hardware-samelement/Panic_button_v2.0/README.md

# Panic_button_v2.0
 Panic Button version 2, new PCB using esp32.
