hardware-samelement/Panic_button_v2.0/document/dokumentasi-panic-button_v2.0.docx

# Panic Button v2

Merupakan upgrade dari versi sebelumnya yaitu v1.1. yang paling membedakan adalah controller diupgrade ke esp32 yang sebelumnya esp12-E.

## Hardware

Untuk board, tidak ada perubahan dari segi bentuk dan dimensi, masih sama dengan versi sebelumnya.

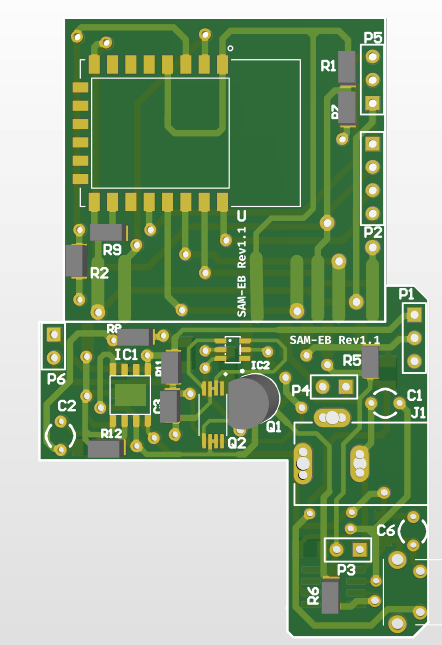
[picture p1: figure]

Gambar 1 Panic Button V1.1

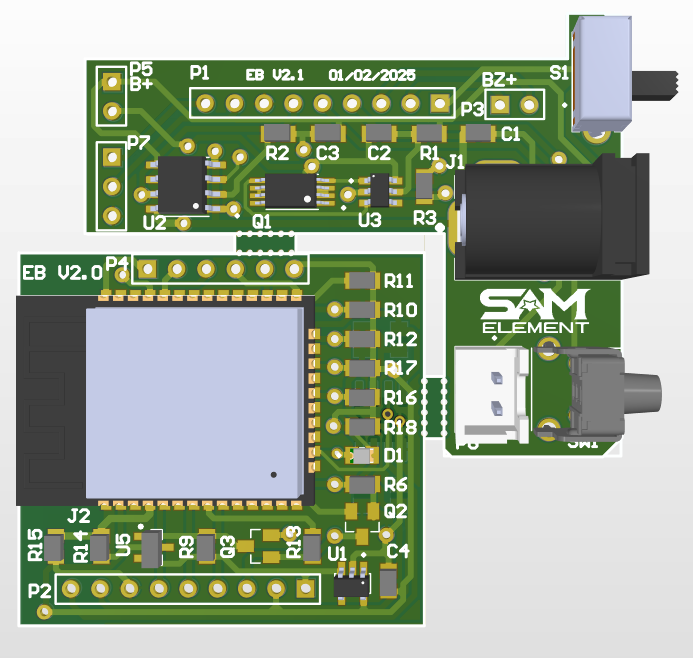
[picture p2: figure]

Gambar 2 Panic Button V2.1

Perubahan yang dapat diperhatikan adalah sebagai berikut:

- Digunakan esp32, letak antenna di luar pcb.
- Rangkaian IC NE555 dihilangkan.
- Ditambahkan regulator 3V3.
- Ditambahkan FET untuk ADC baterai.
- Ditambahkan driver untuk buzzer.
- Header untuk upload code dipindah ke atas.
- Connector antar kedua pcb menggunakan header siku.

### 3.3V regulator

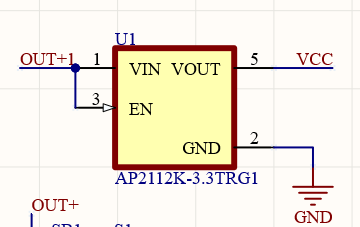
[picture p3: figure]

Gambar 3 LDO 3.3V

Digunakan LDO (low dropout) regulator 3.3V AP2112K, keunggulan regulator tersebut dibanding AMS1117 adalah pada sisi dropoutnya lebih kecil. Sehingga pada saat tegangan baterai sudah ada di 3.7V regulator tersebut masih bisa stabil mengeluarkan tegangan di 3.3V. pada versi 1.1 tidak terdapat regulator sama sekali, esp langsung mendapat tegangan dari baterai.

### Enable untuk cek adc baterai

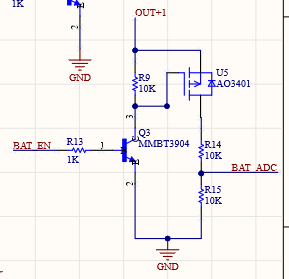
[picture p4: figure]

Gambar 4 rangkain FET untuk adc baterai

Ditambahkan fet untuk enable adc baterai, sehingga pada saat tidak melakukan pengukuran baterai maka potensi power lost pada resistor pembagi tegangan sebelum adc dapat dihilangkan.

### Penambahan komunikasi RS45

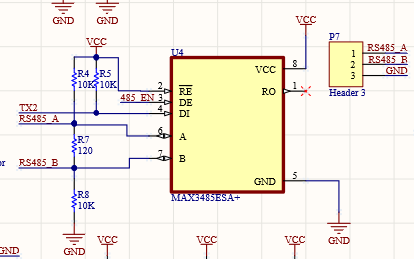
[picture p5: figure]

Gambar 5 rangkaian MAX485

Juga ditambahkan untuk komunikasi max485, antisipasi jika ingin digunakan dengan kabel.

## Firmware

Untuk firmware, terdapat 2 jenis tombol dan 2 jenis komunikasi yang dapat digunakan. Perbedaan tersebut dapat dipilih melalui flag yang ada, flag tersebut yang kemudian akan digunakan untuk memilih task mana yang diaktifkan.

ButtonType buttonType = BUTTON_NC_LOCKED;

// ButtonType buttonType = BUTTON_NO_MOMENTARY;

ConnectivityType connectionType = CONNECTION_WiFi;

// ConnectivityType connectionType = CONNECTION_ESPNOW;

void setup() {

// put your setup code here, to run once:

pinConfig();

Serial.begin(115200);

batteryCalculate();

if (connectionType == CONNECTION_WiFi) {

xTaskCreate(task_wifi, "wifi", 1024 * 8, NULL, 3, NULL);

} else if (connectionType == CONNECTION_ESPNOW) {

xTaskCreate(task_espnow, "esp now", 1024 * 3, NULL, 2, NULL);

}

if (buttonType == BUTTON_NC_LOCKED) {

xTaskCreate(task_button, "button", 1024 * 2, NULL, 1, NULL); // locked NC switch

} else if (buttonType == BUTTON_NC_LOCKED) {

xTaskCreate(task_button2, "button2", 1024 * 2, NULL, 1, NULL); // momentary NO switch

}

xTaskCreate(task_led, "led", 1024, NULL, 1, NULL);

xTaskCreate(task_buzzer, "buzzer", 1024, NULL, 1, NULL);

}

### Button locked NC

Button locked NC merupakan

void task_button(void *pvParameter) {

esp_sleep_enable_ext0_wakeup(PIN_WAKE_UP, HIGH);

if (digitalRead(PIN_WIFI_RESET) == LOW) {

if (connectionType == CONNECTION_WiFi) {

status.apMode = true;

Serial.println("apMode detected");

} else if (connectionType == CONNECTION_ESPNOW) {

pairingMode = true;

Serial.println("Pairing Mode detected");

}

} else {

if (connectionType == CONNECTION_WiFi) {

status.apMode = false;

Serial.println("no apMode detected");

} else if (connectionType == CONNECTION_ESPNOW) {

pairingMode = false;

Serial.println("no Pairing Mode detected");

}

}

while (1) {

if (digitalRead(PIN_BUTTON_MAIN) == HIGH) {

status.emergency = true;

led.offDelay = 100;

} else if (digitalRead(PIN_BUTTON_MAIN == LOW)) {

status.emergency = false;

led.offDelay = 500;

}

vTaskDelay(10);

}

}

Jika pada saat awal nyala (baik power on atau wake up). Tombol wifi reset ditekan, maka akan mengaktifkan apMode untuk memasukkan WiFi config atau pairing esp now. Sedangkan pada saat wifi reset tidak tertekan, maka akan emergency seperti biasa.

Jika tombol tertekan maka akan mendeteksi emergency, sedangkan pada saat dilepas status emergency tersebut dihilangkan.

### Button momentary NO

void task_button2(void *pvParameter) {

esp_sleep_enable_ext0_wakeup(PIN_WAKE_UP, LOW);

Button mainButton(PIN_BUTTON_MAIN);

uint8_t counter = 0;

esp_reset_reason_t resetReason = esp_reset_reason();

if (digitalRead(PIN_WIFI_RESET) == LOW) {

status.apMode = true;

pairingMode = true;

Serial.println("apMode detected");

} else {

status.apMode = false;

pairingMode = false;

Serial.println("no AP mode");

}

while (digitalRead(PIN_BUTTON_MAIN) == LOW) {

vTaskDelay(100);

counter++;

if (counter > 30)

break;

}

if (counter < 30) { // pressed less than 3 second after start

if (!status.apMode) {

if (resetReason == ESP_RST_DEEPSLEEP) {

status.emergency = true;

log_i("emergency true");

led.offDelay = 100;

}

}

} else {

pairingMode = true;

}

while (1) {

if (mainButton.read() == LOW) {

if (!mainButton.pressed) {

mainButton.pressed = true;

mainButton.startTime = millis();

}

if (millis() - mainButton.startTime > 1000 && !mainButton.longPressed) {

mainButton.longPressed = true;

// button long pressed

log_i("main button long pressed");

if (status.emergency == true) {

status.emergency = false;

led.offDelay = 500;

}

vTaskDelay(500);

}

} else { // button released

if (mainButton.pressed) {

if (mainButton.longPressed) {

mainButton.longPressed = false;

} else {

// button short pressed

log_i("main button short pressed");

if (!pairingMode) {

if (!status.emergency) {

status.emergency = true;

log_i("emergency true");

led.offDelay = 100;

}

}

}

vTaskDelay(100);

mainButton.pressed = false;

}

}

vTaskDelay(10);

taskYIELD();

}

}

Karena button adalah momentary switch, pada saat awal device menyala akan dicek terlebih dahulu apakah tombol ditekan selama 3 detik atau kurang. Jika lebih dari 3 detik maka akan masuk pada mode ap untuk set wifi config atau pairing esp-now.

Jika kurang dari itu maka akan menyalakan status emergency dan langsung masuk pada loop. Karena tombol berupa momentary switch, untuk mematikan harus menekan tombol lagi. Untuk pengaman jika tombol dipencet berulang tidak nyala mati terus menerus, maka untuk mematikan digunakan long press selama 1 detik.

### Wifi mqtt

void task_wifi(void *pvParameter) {

iot_init();

int counter = 0;

bool sleep_ok = false;

vTaskDelay(500);

while (1) {

vTaskDelay(10);

iot_loop();

if (WiFi.status() == WL_CONNECTED || WiFi.status() == WL_CONNECT_FAILED) {

sleep_ok = true;

}

if (iot_isConnected()) {

led.onDelay = 100;

buzzerDelay = 400;

// send battery information

if (battery.isCharging) {

iot_publish("sensor/status", "Charging");

} else {

if (battery.voltage > 4.8) {

iot_publish("sensor/status", "No Battery");

} else {

iot_publish("sensor/status", "On Battery");

}

}

// batt

char batteryPercentageBuffer[3];

sprintf(batteryPercentageBuffer, "%d", battery.percentage);

iot_publish("sensor/battery", batteryPercentageBuffer);

// send emergency

while (status.emergency) {

// timer for publish, 1 count = 1s, publish every 10 second.

if (counter == 0) {

iot_publish("sensor/emergency", "true");

if (SIRENE_SN != "") {

char sirene_topic[50];

sprintf(sirene_topic, "1/%s/relay/onoff/set", SIRENE_SN);

iot_publish(sirene_topic, "true");

}

}

Serial.println(counter);

vTaskDelay(1000);

counter == 10 ? counter = 0 : counter++;

}

// if not emergency, and emergency already done.

iot_publish("sensor/emergency", "false");

if (SIRENE_SN != "") {

char sirene_topic[50];

sprintf(sirene_topic, "1/%s/relay/onoff/set", SIRENE_SN);

iot_publish(sirene_topic, "false");

}

} else {

led.onDelay = 500;

}

if (!(status.emergency || status.apMode)) {

if (sleep_ok) {

Serial.println("sleeping");

iot_publish("$state", "sleeping");

delay(3000);

ESP.deepSleep(24 * HOUR_MULTIPLIER);

}

}

}

}

Untuk task wifi mqtt, pertama dilakukan init mqtt seperti biasanya. Kemudian pada loop, dilakukan pengecekan apakah wifi sudah terhubung atau gagal, jika terhubung maka akan publish untuk baterai information, jika status.emergency true maka akan publish ke server tiap 10 detik. jika sudah keluar dari status emergency, maka akan publish emergency false dan esp akan sleep.

### Esp-now

void task_espnow(void *pvParameter) {

void task_espnow(void *pvParameter) {

bool temp;

bool emergencyEnd = false;

my_espnow_init();

while (1) {

if (pairingMode) {

my_espnow_pairing();

pairingMode = false;

}

// wait for emergency status true, max 3 second

for (int i = 0; i < 30; i++) {

if (status.emergecy) {

break;

}

vTaskDelay(100);

}

while (status.emergency) {

myData.msgType = DATA;

myData.emergencyStatus = status.emergency;

myData.batteryStatus = battery.isCharging;

myData.batteryPercentage = uint8_t(battery.percentage);

esp_now_send(NULL, (uint8_t *)&myData, sizeof(myData));

vTaskDelay(1000);

}

if (!status.emergency) {

myData.msgType = DATA;

myData.emergencyStatus = status.emergency;

esp_now_send(NULL, (uint8_t *)&myData, sizeof(myData));

}

if (!(status.emergency || pairingMode)) {

Serial.println("sleeping");

vTaskDelay(500);

ESP.deepSleep(24 * HOUR_MULTIPLIER);

}

}

vTaskDelay(1);

}

Untuk task esp now, dilakukan init kemudian masuk ke dalam loop, seperti pada task wifi, jika status.emergency true maka akan kirim data pada gateway melalui esp-now. Jika sudah keluar dari status emergency maka langsung mengirim false dan sleep esp.

void my_espnow_init(void) {

getSerial();

file.init();

String fileJson = file.readFile(SPIFFS, "/peer.json");

log_i("here");

deserializeJson(peerDataJson, fileJson);

serializeJsonPretty(peerDataJson, Serial);

if (!peerDataJson.isNull()) {

const char *temp = peerDataJson["peer_addr"];

uint8_t temp2[6];

for (int i = 0; i < 6; i++) {

temp2[i] = (uint8_t)temp[i];

}

memcpy(peerInfo.peer_addr, temp2, 6);

Serial.println(peerInfo.peer_addr[1]);

peerInfo.channel = peerDataJson["channel"];

Serial.println(peerInfo.channel);

peerInfo.encrypt = peerDataJson["encrypt"];

Serial.println(peerInfo.encrypt);

}

WiFi.mode(WIFI_MODE_STA);

getMacAddress();

if (esp_now_init() != ESP_OK) {

Serial.println("ESP NOW Init Failed");

}

esp_wifi_set_channel(peerInfo.channel, WIFI_SECOND_CHAN_NONE);

// Add peer

if (esp_now_add_peer(&peerInfo) != ESP_OK) {

Serial.println("Failed to add peer");

} else {

Serial.println("success add peer");

}

esp_now_register_send_cb(onDataSent);

esp_now_register_recv_cb(esp_now_recv_cb_t(onDataReceive));

}

Untuk init esp-now, mengambil data mac address milik gateway yang tersimpan pada file system. Mac tersebut sebelumnya didapat pada proses pairing, untuk penjelasan pairing dapat dilihat pada document esp-now-gateway.

Kemudian melakukan init esp-now dan add peer milik gateway.
