hardware-samelement/Panic_button_v2.0/document/Custom widget emergency.docx

# Custom widget emergency/panic button

$model : “SAM-EB

$nodes : “sensor”

Sensor/$properties : "emergency,battery,status"

Sensor/emergency/$name : “EMERGENCY”

Sensor/emergency/$datatype : “Boolean”

//true = emergency on

Sensor/battery/$name : “Battery Percentage”

Sensor/battery/$datatype : “integer”

Sensor/battery/$unit : “%

Sensor/battery/$format : “0:100”

Sensor/status /$name : “Charging Status”

Sensor/status /$datatype : “String”

//status berisi dapat string “Charging”, “On Battery”, dan “No Battery”
