hardware-samelement/Panic_button_v2.0/PCB/Emergency Button v2_0 - with RS485/Bom_Emergency Button v2_0.xlsx

Bill of Materials
Source Data From: |  | Emergency Button v2_0.PrjPcb
Project: |  | Emergency Button v2_0.PrjPcb
Variant: |  | None
Creation Date: | 9/17/2024 | 10:22
Print Date: | 2024-09-17 | 13:49:36
Designator | Description | Comment | Quantity | Component Ready | Notes | Link 1 | Link 2
C1, C2, C3, C4 | Capacitor | C 100n | 4 | TRUE |  | https://www.tokopedia.com/lisuinstrument/100nf-10-100v-x7r-0805-multilayer-ceramic-capacitors-mlcc-smd-smt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
D1 | LED Red | LED 0805 | 1 | TRUE
J1 | DC Power Jack | PJ-002A | 1 | FALSE |  | https://www.tokopedia.com/jogjarobotika/soket-dc-power-jack-dc-female-socket-5-5x2-1mm-pcb-soket-power-dc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
J2 | ESP32-WROOM-32E | ESP32-WROOM-32E | 1 | TRUE | Sisa 2 | https://www.tokopedia.com/jogjarobotika/esp32-esp-32-esp32s-esp-wroom-32-wifi-bluetooth-ble-chip-iot-module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
P1, P2 | Header, 9-Pin | PCB connector | 2 | FALSE |  | https://www.tokopedia.com/lisuinstrument/pin-header-2-54mm-male-40-pin-single-row-strip-breakable-connector-putih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
P3 | Header, 2-Pin | Buzzer | 1 | FALSE
P4 | Header, 6-Pin | Flash port | 1 | FALSE
P5 | Header, 2-Pin | BATT | 1 | FALSE
P6 | JST-XH, 2-Pin | BTN | 1 | FALSE
P7 | Header, 3-Pin | Header 3 | 1 | FALSE
Q1 | N/A | FS8205A | 1 | TRUE
Q2, Q3 | Bipolar _BJT_ Transistor NPN 40V 200mA 270MHz 350mW Surface Mount SOT-23-3 | MMBT3904 | 2 | FALSE |  | https://www.tokopedia.com/jogjarobotika/mmbt3904-sot23-smd-npn-transistor
R1 | Resistor | R 100 | 1 | FALSE |  | https://www.tokopedia.com/lisuinstrument/100-0805-1-125mw-150v-100ppm-thick-film-resistors-100r-100-1000-0805w8f1000t5e-uni-royal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
R2 | Resistor | R 1.2K | 1 | FALSE |  | https://www.tokopedia.com/lisuinstrument/1-2k-0805-1-thick-film-resistors-smd-chip-resistor-1201-1k2-1-2k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
R3, R6, R13, R18 | Resistor | R 1K | 4 | TRUE |  | https://www.tokopedia.com/lisuinstrument/1k-0805-1-thick-film-resistors-smd-chip-resistor-1001-1k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
R4, R5, R8, R9, R10, R11, R12, R14, R15, R16, R17 | Resistor | R 10K | 11 | FALSE |  | https://www.tokopedia.com/jogjarobotika/10k-ohm-smd0805-resistor-1?extParam=src%3Dshop%26whid%3D3000837
R7 | Resistor | R 120 | 1 | FALSE |  | https://www.tokopedia.com/lisuinstrument/120r-0805-1-thick-film-resistors-smd-chip-resistor-1200-121-120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
S1 | Slide Switch SPDT Through Hole, Right Angle | EG1247 | 1 | TRUE
SB1 |  | solder bridge 3pin | 1 | TRUE
SW1 | Tactile Switch Right Angle | Wifi Reset | 1 | TRUE
U1 | Linear Voltage Regulator Output 600mA | AP2112K-3.3TRG1 | 1 | FALSE |  | https://www.tokopedia.com/jogjarobotika/g3p-ap2112k-3-3-3-3v-sot-23-5-sot-25-600ma-cmos-ldo-regulator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
U2 | Complete single cell Li-Ion battery with a constant current / constant voltage linear charger | TP4056 | 1 | TRUE | Sisa 2
U3 | One Cell Lithium-ion/Polymer Battery Protection IC | DW01A | 1 | TRUE
U4 | half duplex RS485 | MAX3485ESA+ | 1 | FALSE |  | https://www.tokopedia.com/dimer-dc-2000/max3485-max-3485-esa-3485-sop8-transceivers-ic
U5 | P-Channel 30V 4A (Ta) 1.4W (Ta) Surface Mount SOT-23-3L | AO3401 | 1 | TRUE |  | https://www.tokopedia.com/lisuinstrument/ao3401-3401-a19t-30v-p-channel-mosfet-ao3401a-sot-23-generic-biasa-3b2c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
