hardware-samelement/Panic_button_v2.0/PCB/Emergency Button v2_0 - with RS485/Project Outputs for Emergency Button v2_1/Emergency Button v2_1.xls

 |  | Component list |  |  | Bill of Materials for PCB Document [Emergency_Button_v2_1.PcbDoc]
 |  | Source Data From: |  |  | Emergency_Button_v2_1.PcbDoc
 |  | Project: |  |  | Emergency Button v2_1.PrjPcb
 |  | Variant: |  |  | None
 |  | Report Date: |  | 2/5/2025 | 15:33
 |  | Print Date: |  | 2025-02-05 | 15:33:40
Description | Footprint | Quantity | Designator | #Column Name Error:' Supplier Order Qty 1 | #Column Name Error:' Manufacturer 1 | #Column Name Error:' Manufacturer Part Number 1 | #Column Name Error:' Supplier Unit Price 1 | #Column Name Error:' Supplier Subtotal per Board 1 | #Column Name Error:' Supplier Order Qty 2 | #Column Name Error:' Manufacturer 2 | #Column Name Error:' Manufacturer Part Number 2 | #Column Name Error:' Supplier Unit Price 2 | #Column Name Error:' Supplier Currency 1 | Total Price
Capacitor | 6-0805_N | 4 | C1, C2, C3, C4 |  |  |  |  |  |  |  |  |  |  | 0
LED Red | LEDC2012X70N | 1 | D1 |  |  |  |  |  |  |  |  |  |  | 0
DC Power Jack | CUI_PJ-002A | 1 | J1 |  |  |  |  |  |  |  |  |  |  | 0
ESP32-WROOM-32E | ESP32-WROOM-32E | 1 | J2 |  |  |  |  |  |  |  |  |  |  | 0
Header, 9-Pin | HDR1X9 | 2 | P1, P2 |  |  |  |  |  |  |  |  |  |  | 0
Header, 2-Pin | HDR1X2 | 1 | P3 |  |  |  |  |  |  |  |  |  |  | 0
Header, 6-Pin | HDR1X6 | 1 | P4 |  |  |  |  |  |  |  |  |  |  | 0
Header, 2-Pin | HDR1X2 | 1 | P5 |  |  |  |  |  |  |  |  |  |  | 0
JST-XH, 2-Pin | JST_B2B-XH-A(LF)(SN) | 1 | P6 |  |  |  |  |  |  |  |  |  |  | 0
Header, 3-Pin | HDR1X3 | 1 | P7 |  |  |  |  |  |  |  |  |  |  | 0
N/A | SOP65P640X120-8N | 1 | Q1 |  |  |  |  |  |  |  |  |  |  | 0
Bipolar _BJT_ Transistor NPN 40V 200mA 270MHz 350mW Surface Mount SOT-23-3 | SOT95P240X120-3N | 2 | Q2, Q3 |  |  |  |  |  |  |  |  |  |  | 0
Resistor | 6-0805_N | 1 | R1 |  |  |  |  |  |  |  |  |  |  | 0
Resistor | 6-0805_N | 1 | R2 |  |  |  |  |  |  |  |  |  |  | 0
Resistor | 6-0805_N | 4 | R3, R6, R13, R18 |  |  |  |  |  |  |  |  |  |  | 0
Resistor | 6-0805_N | 11 | R4, R5, R8, R9, R10, R11, R12, R14, R15, R16, R17 |  |  |  |  |  |  |  |  |  |  | 0
Resistor | 6-0805_N | 1 | R7 |  |  |  |  |  |  |  |  |  |  | 0
Slide Switch SPDT Through Hole, Right Angle | SW_EG1247 | 1 | S1 |  |  |  |  |  |  |  |  |  |  | 0
 | SOLDER BRIDGE 3 | 1 | SB1 |  |  |  |  |  |  |  |  |  |  | 0
Tactile Switch Right Angle | SW_1825027-5 | 1 | SW1 |  |  |  |  |  |  |  |  |  |  | 0
Linear Voltage Regulator Output 600mA | SOT95P285X140-5N | 1 | U1 |  |  |  |  |  |  |  |  |  |  | 0
Complete single cell Li-Ion battery with a constant current / constant voltage linear charger | SOP127P600X175-9N | 1 | U2 |  |  |  |  |  |  |  |  |  |  | 0
One Cell Lithium-ion/Polymer Battery Protection IC | SOT95P280X145-6N | 1 | U3 |  |  |  |  |  |  |  |  |  |  | 0
half duplex RS485 | SOIC127P600X175-8N | 1 | U4 |  |  |  |  |  |  |  |  |  |  | 0
P-Channel 30V 4A (Ta) 1.4W (Ta) Surface Mount SOT-23-3L | SOT-23_N | 1 | U5 |  |  |  |  |  |  |  |  |  |  | 0
