hardware-samelement/Panic_button_v2.0/PCB/Emergency Button v2_0 - with RS485/EB_lay_top.pdf

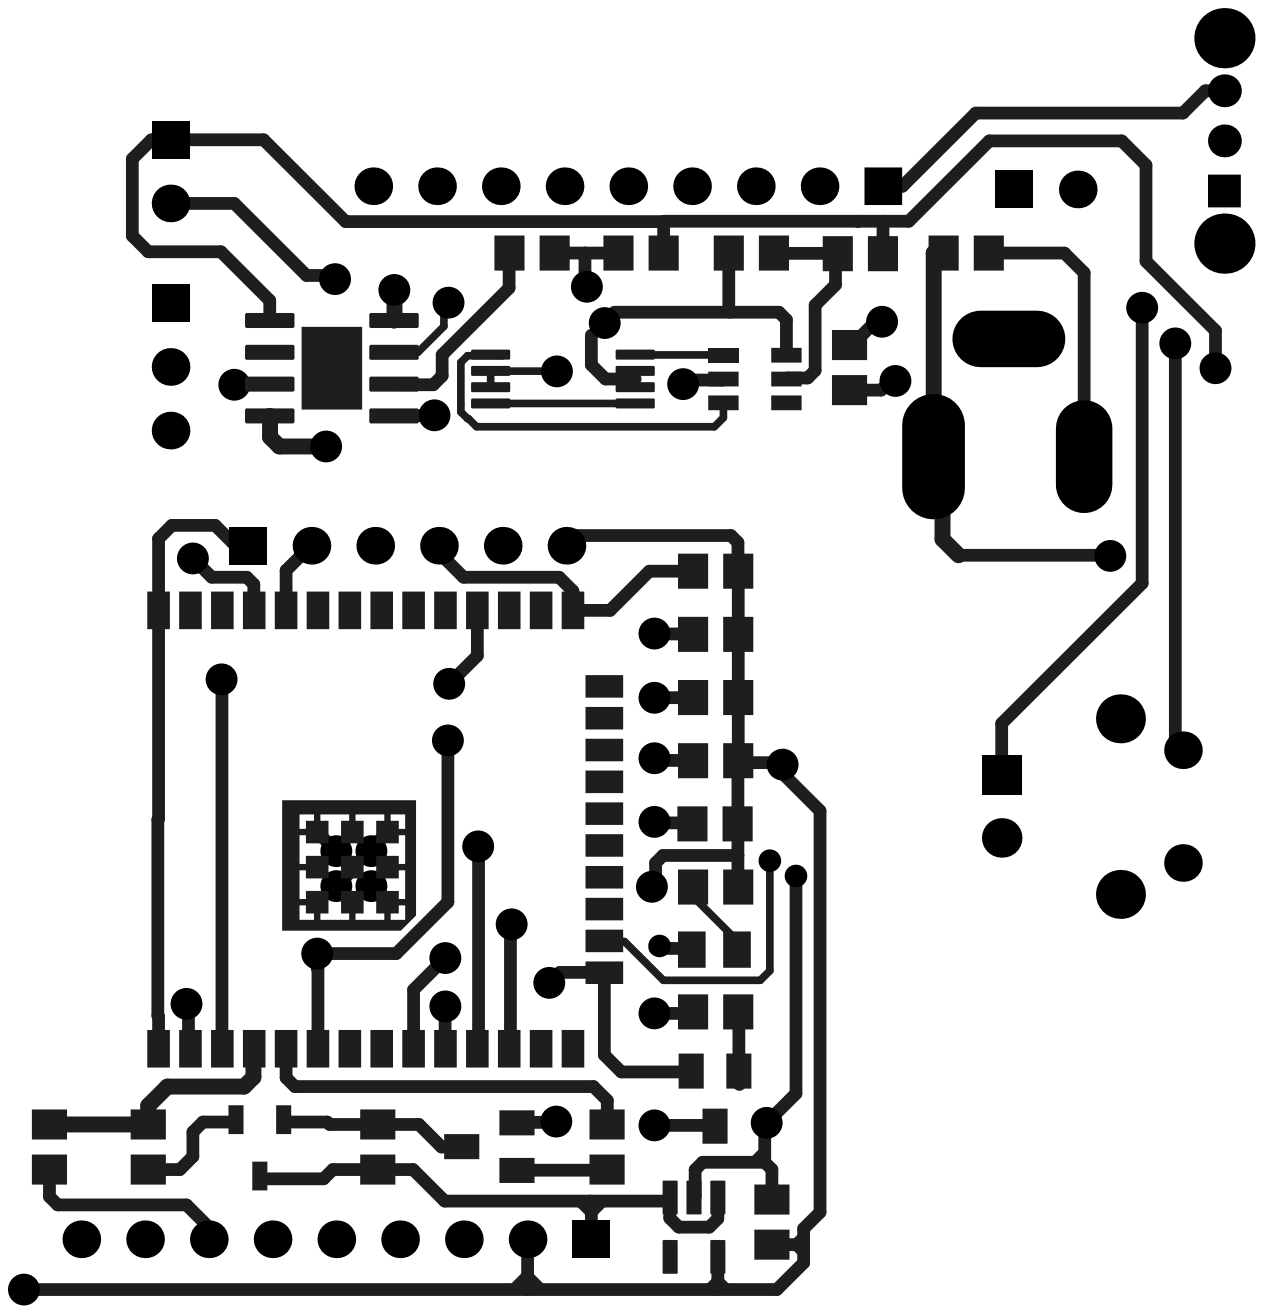
[picture p7: page 1]
