hardware-samelement/Panic_button_v2.0/PCB/Emergency Button v2_0 - with RS485/EB_ovl_bot.pdf

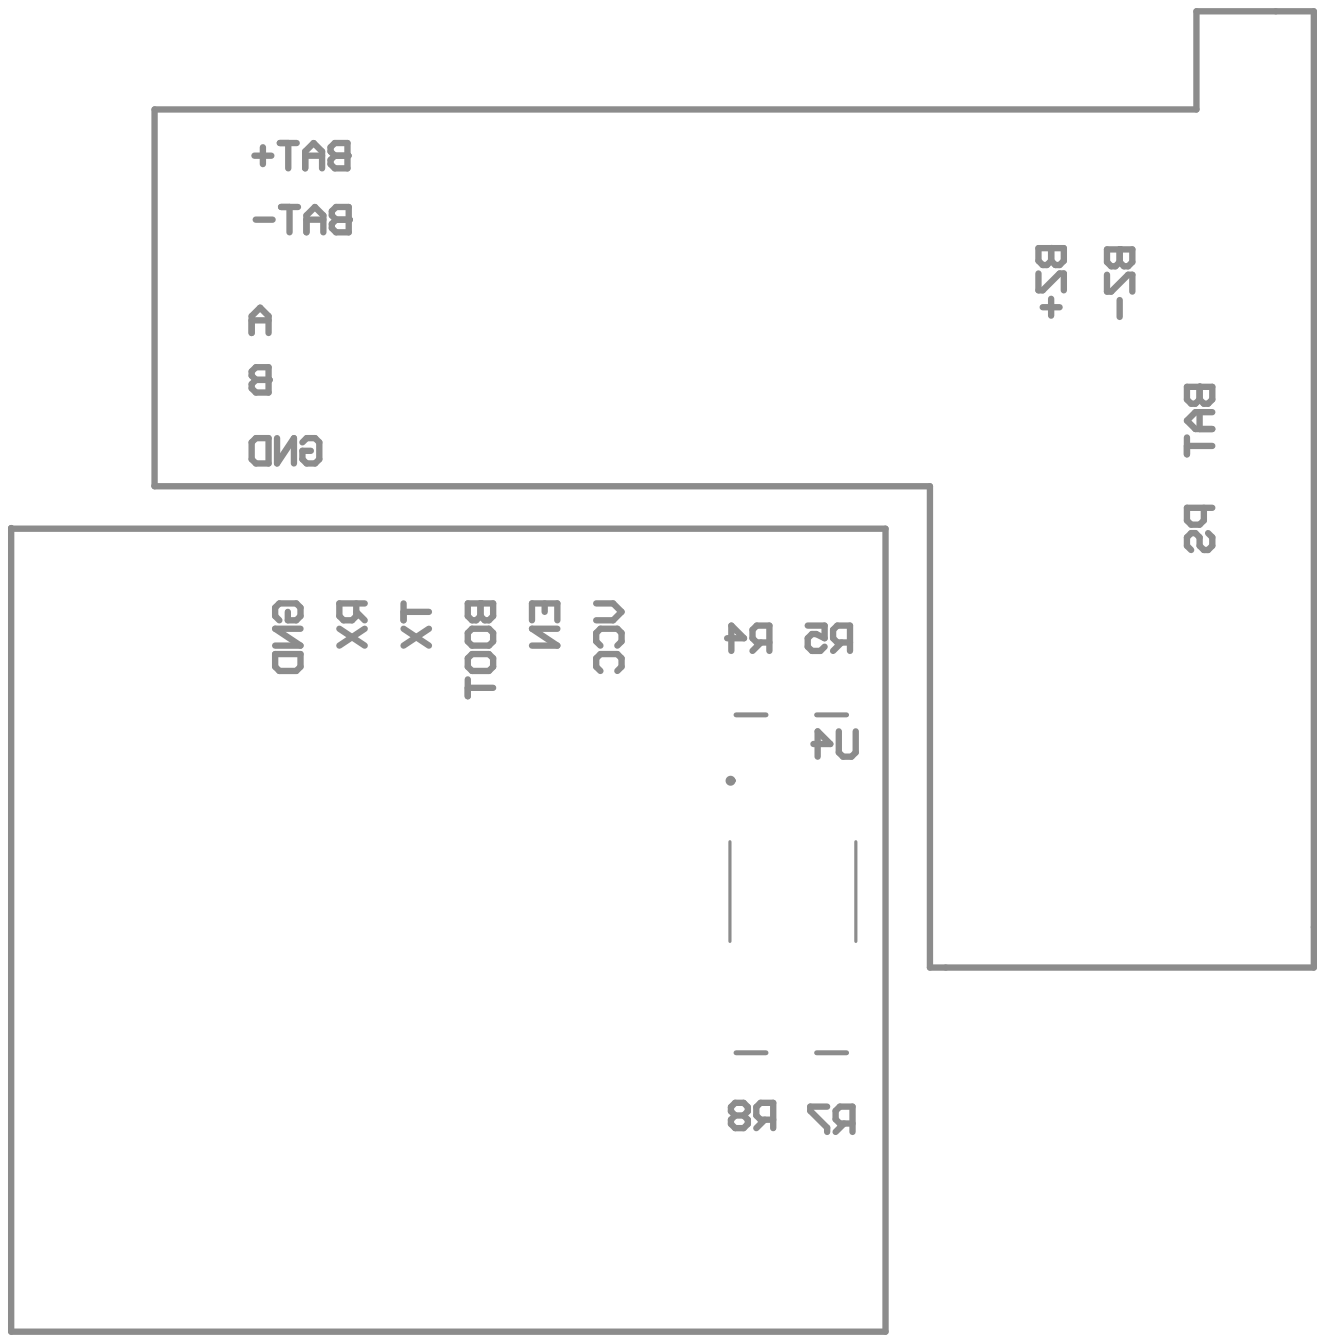
[picture p8: page 1]
