hardware-samelement/Panic_button_v2.0/(list of files, drawings)

Other design files:
PCB/Emergency Button v2_0 - with RS485/Copy of Emergency_Button_v2_0.PcbDoc
PCB/Emergency Button v2_0 - with RS485/Emergency Button v1_3.PrjPcb
PCB/Emergency Button v2_0 - with RS485/Emergency Button v2_0.PrjPcb
PCB/Emergency Button v2_0 - with RS485/Emergency Button v2_1.PrjPcb
PCB/Emergency Button v2_0 - with RS485/Emergency_Button_v2_0.PcbDoc
PCB/Emergency Button v2_0 - with RS485/Emergency_Button_v2_0.SchDoc
PCB/Emergency Button v2_0 - with RS485/Emergency_Button_v2_1.PcbDoc
PCB/Emergency Button v2_0 - with RS485/Emergency_Button_v2_1.SchDoc
PCB/Emergency Button v2_0/Emergency Button v1_3.PrjPcb
PCB/Emergency Button v2_0/Emergency Button v2_0.PrjPcb
PCB/Emergency Button v2_0/Emergency_Button_v2_0.PcbDoc
PCB/Emergency Button v2_0/Emergency_Button_v2_0.SchDoc
