hardware-samelement/Panic_button_v2.0/(commit log)

2024-09-19 add mqtt publish
    add mqtt publish data for emergency and battery.
    adjust led blinking delay for various condition.
2024-11-13 add button temporary, esp now.
    -add code for NO teporary as task_button2
    -add esp now code.
2024-11-14 add device model to data struct
2024-12-10 change battery status, restart on wifi changed
    - change mqtt battery percentage status, from using string to integer.
    - add status "Charging", "On Battery" and "No Battery".
    - add restart after wifi changed.
2025-03-24 change directory
    [Bom_Emergency Button v2_0.xlsx, Copy of Emergency_Button_v2_0.PcbDoc, Emergency Button v1_3.PrjPcb, Emergency Button v2_0.PrjPcb, Emergency Button v2_0.xlsx, Emergency Button v2_1.PrjPcb, Emergency Button v2_1.xls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]
